TimTini/modular-window-screen/exports/fit-kit.png

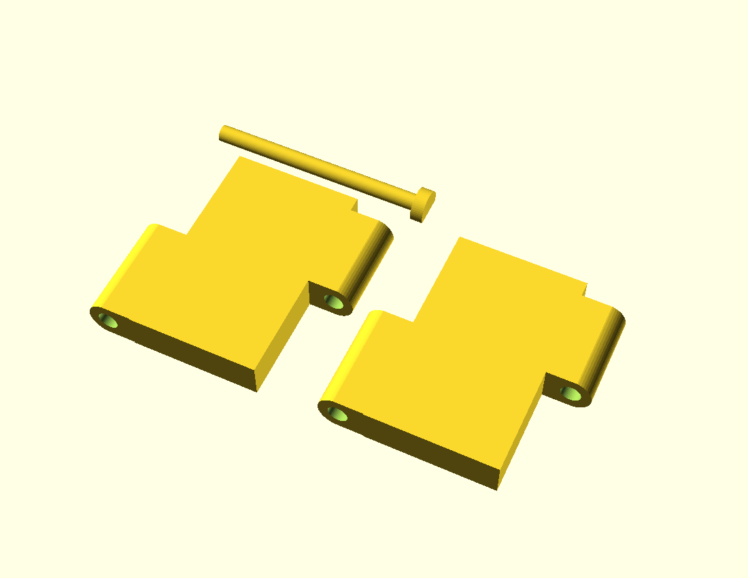
exports/fit-kit.png
