TimTini/modular-window-screen/exports/leaf-section.png

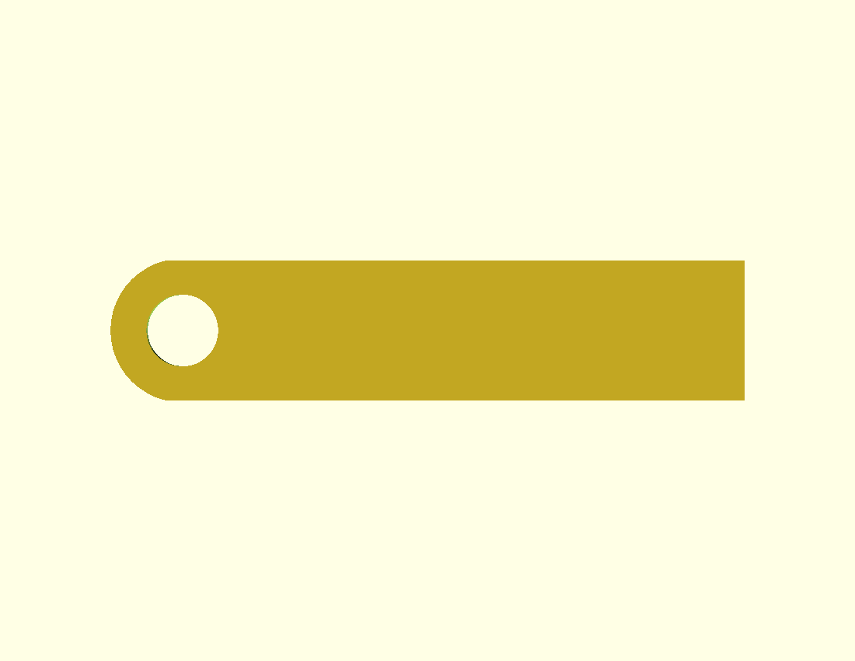
exports/leaf-section.png
