TimTini/modular-window-screen/docs/parts/rod-socket.png

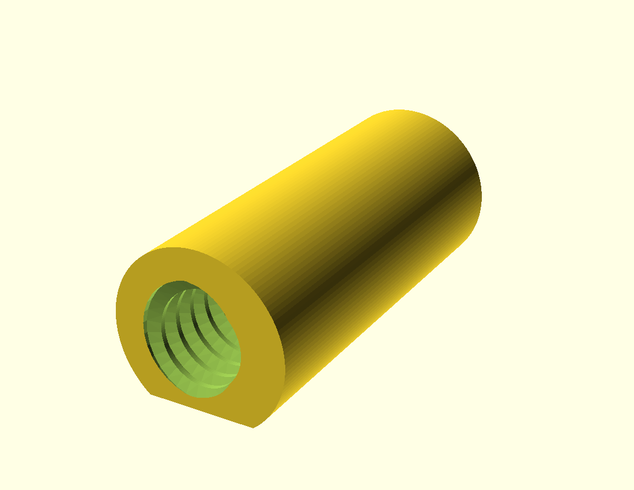
docs/parts/rod-socket.png
