TimTini/modular-window-screen/exports/assembly-tightened.stl

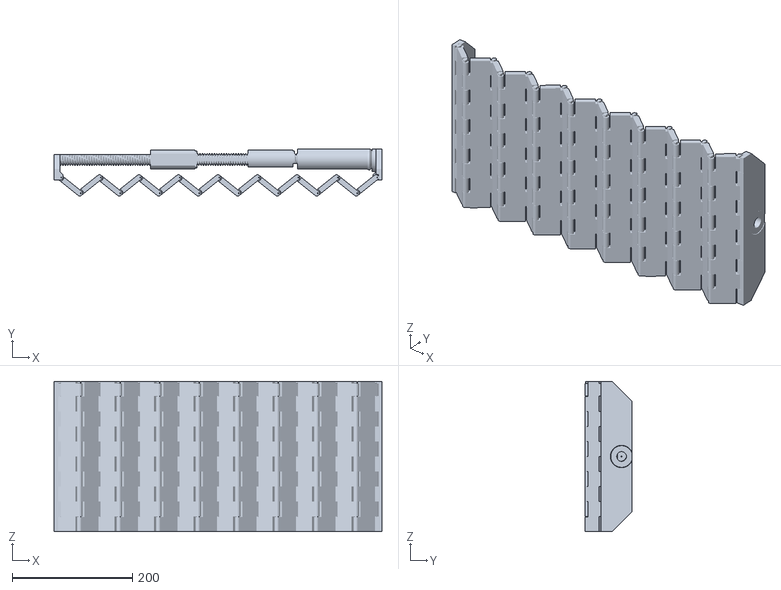
[picture p15: CAD file, 2026-10-26]
exports/assembly-tightened.stl
545.0 x 78.1 x 250.0
