TimTini/modular-window-screen/exports/accordion.3mf

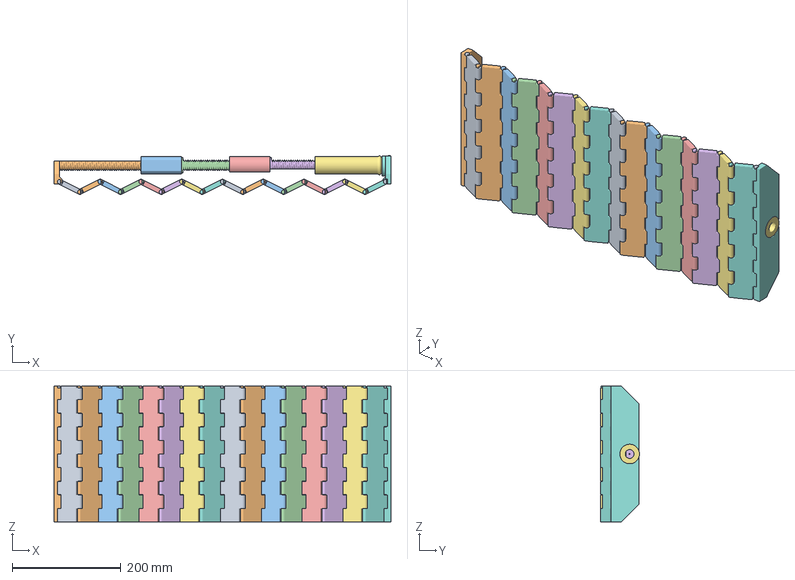
[picture p16: CAD file, 2026-10-26]
exports/accordion.3mf
620.0 x 71.5 x 250.0 mm
leaf-00
leaf-01
leaf-02
leaf-03
leaf-04
leaf-05
leaf-06
leaf-07
leaf-08
leaf-09
leaf-10
leaf-11
leaf-12
leaf-13
leaf-14
leaf-15
pin-00
pin-01
pin-02
pin-03
pin-04
pin-05
pin-06
pin-07
pin-08
pin-09
pin-10
pin-11
pin-12
pin-13
pin-14
pin-15
pin-16
left-support
extension-00-socket
extension-00-shaft
extension-01-socket
extension-01-shaft
female-rotor
right-support
