TimTini/modular-window-screen/exports/parts/rod-extension.stl

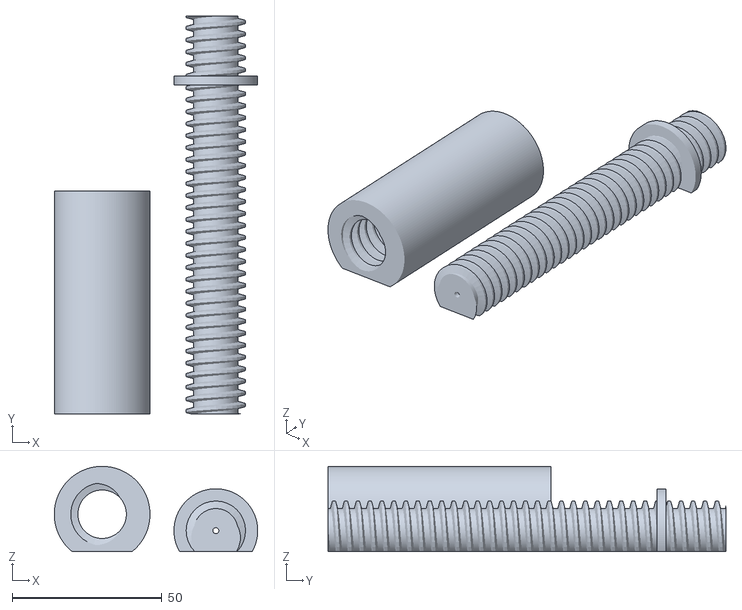
[picture p17: CAD file, 2026-10-26]
exports/parts/rod-extension.stl
68.0 x 133.0 x 28.5
