TimTini/modular-window-screen/exports/fit-kit.stl

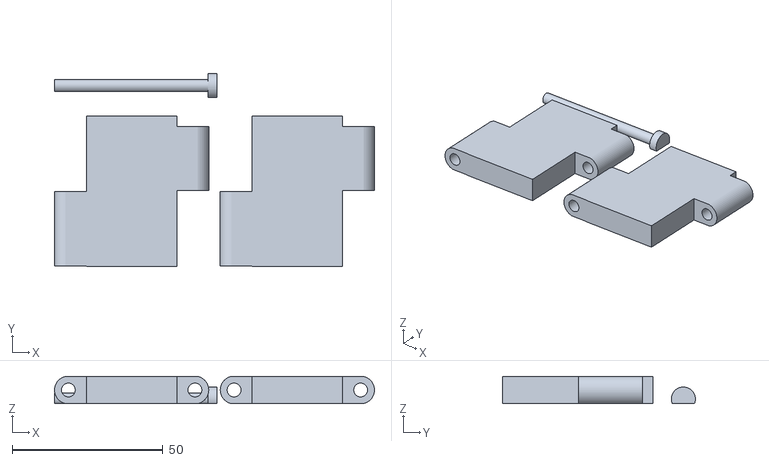
[picture p18: CAD file, 2026-10-26]
exports/fit-kit.stl
106.2 x 64.0 x 9.00
