TimTini/modular-window-screen/exports/parts/hinge-pin.stl

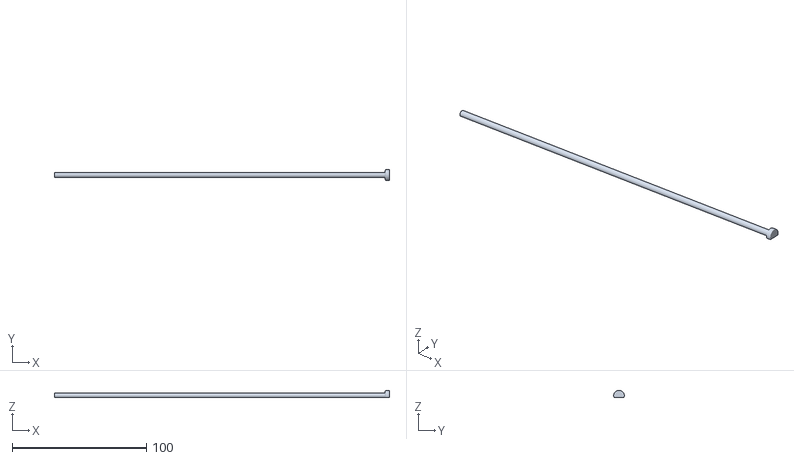
[picture p19: CAD file, 2026-10-26]
exports/parts/hinge-pin.stl
250.0 x 8.00 x 5.50
