TimTini/modular-window-screen/exports/parts/test-female.stl

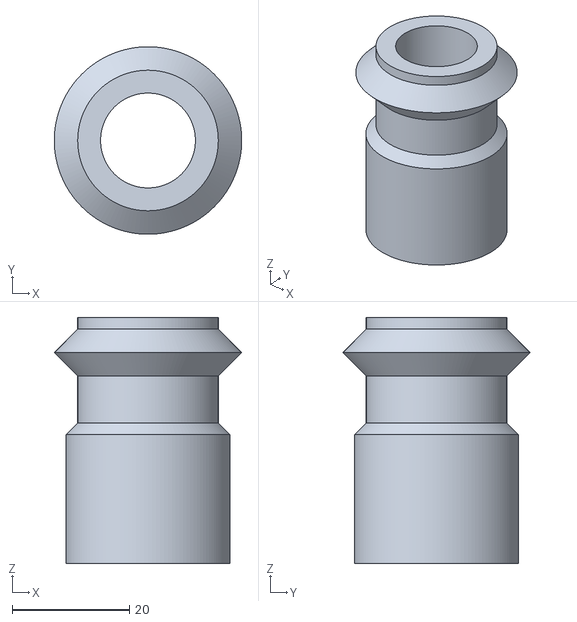
[picture p20: CAD file, 2026-10-26]
exports/parts/test-female.stl
32.0 x 32.0 x 42.0
