TimTini/modular-window-screen/exports/parts/left-support.stl

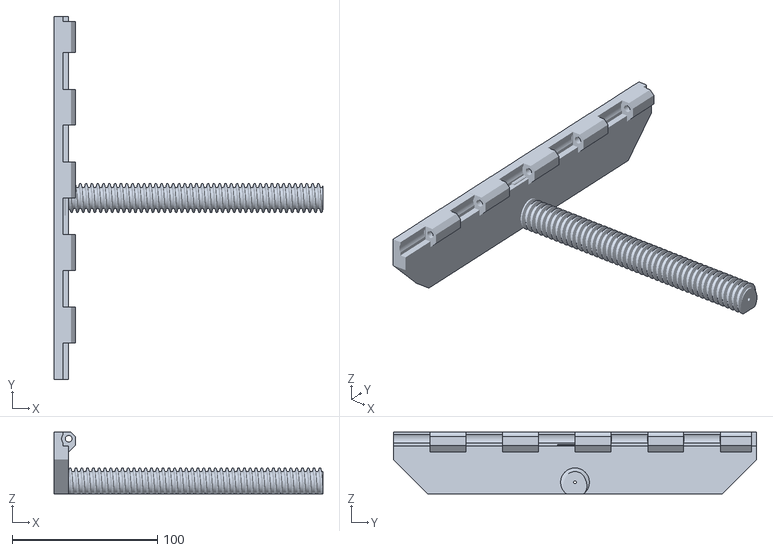
[picture p21: CAD file, 2026-10-26]
exports/parts/left-support.stl
185.0 x 250.0 x 42.6
