TimTini/modular-window-screen/exports/leaf.3mf

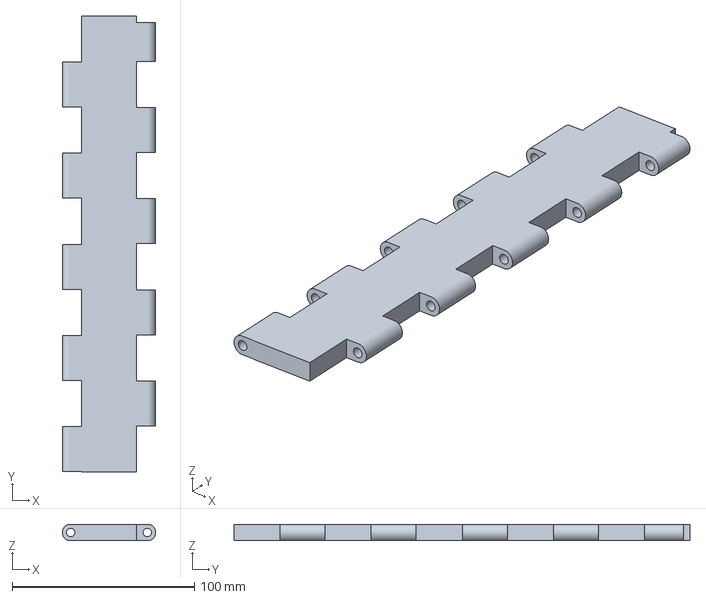
[picture p22: CAD file, 2026-10-26]
exports/leaf.3mf
51.2 x 250.0 x 9.00 mm
