TimTini/modular-window-screen/exports/parts/rod-socket.stl

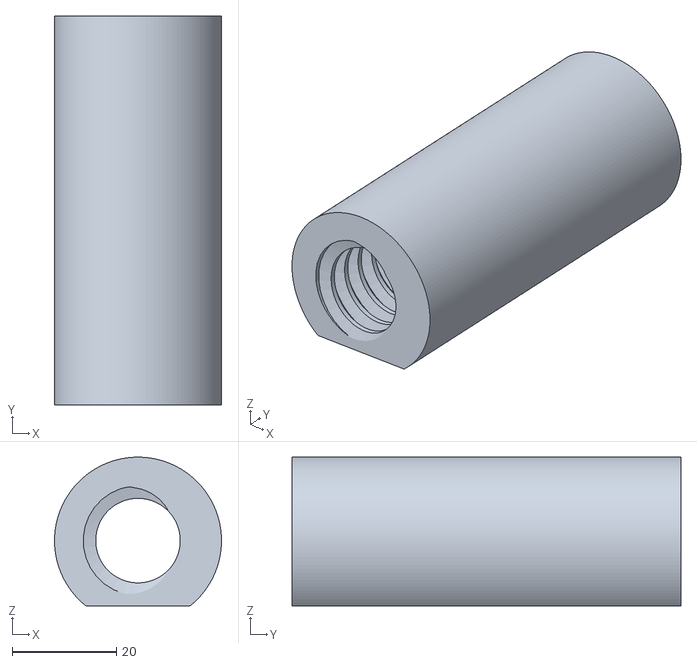
[picture p23: CAD file, 2026-10-26]
exports/parts/rod-socket.stl
32.0 x 74.5 x 28.5
