TimTini/modular-window-screen/exports/parts/right-support.stl

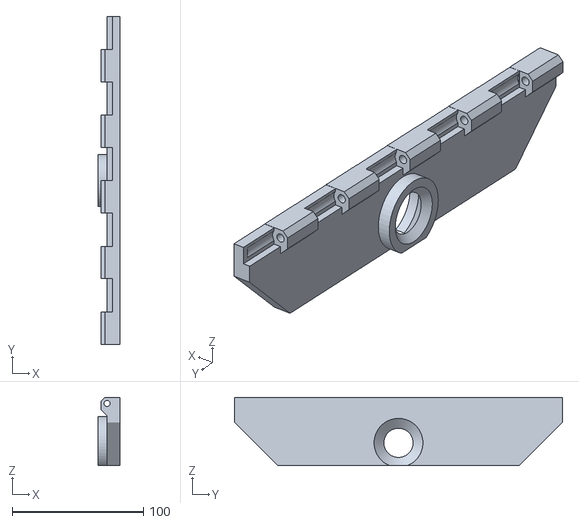
[picture p24: CAD file, 2026-10-26]
exports/parts/right-support.stl
17.0 x 250.0 x 51.9
