TimTini/modular-window-screen/exports/parts/pip-coupon.stl

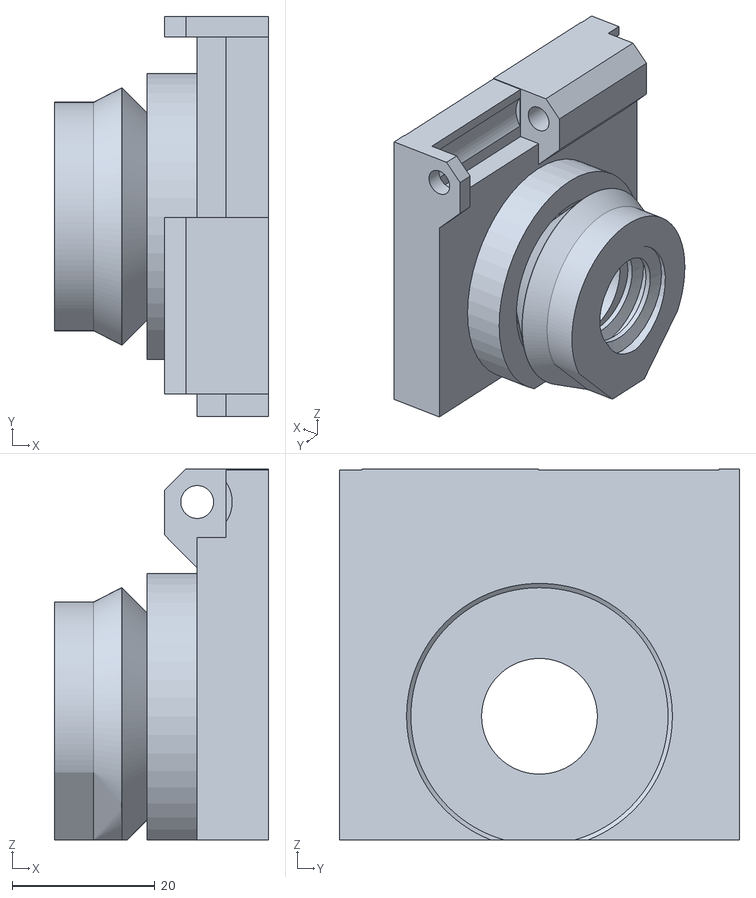
[picture p25: CAD file, 2026-10-26]
exports/parts/pip-coupon.stl
30.0 x 56.0 x 51.9
