TimTini/modular-window-screen/exports/parts/rod-shaft.stl

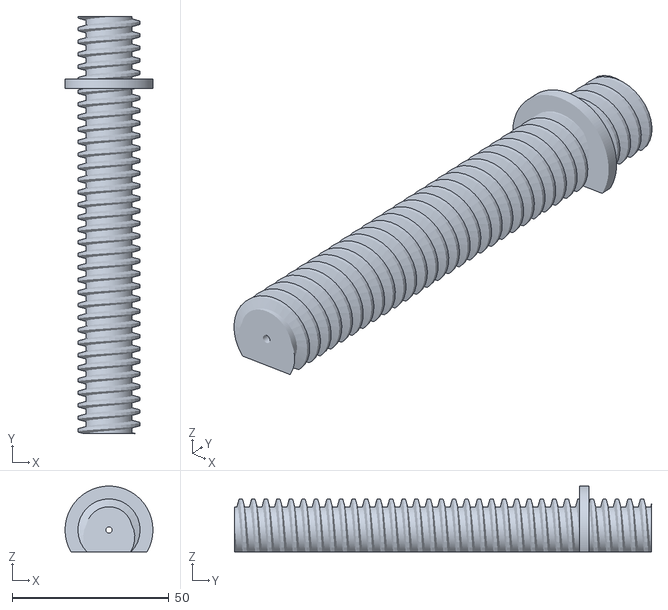
[picture p26: CAD file, 2026-10-26]
exports/parts/rod-shaft.stl
28.0 x 133.0 x 21.0
