TimTini/modular-window-screen/exports/parts/right-pip.3mf

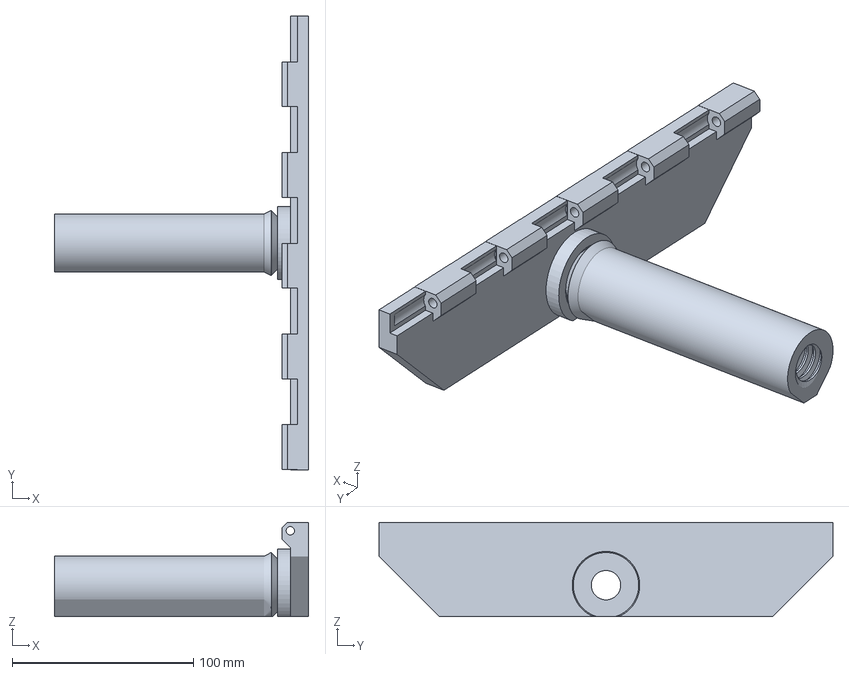
[picture p27: CAD file, 2026-10-26]
exports/parts/right-pip.3mf
140.0 x 250.0 x 51.9 mm
