TimTini/modular-window-screen/exports/parts/test-male.stl

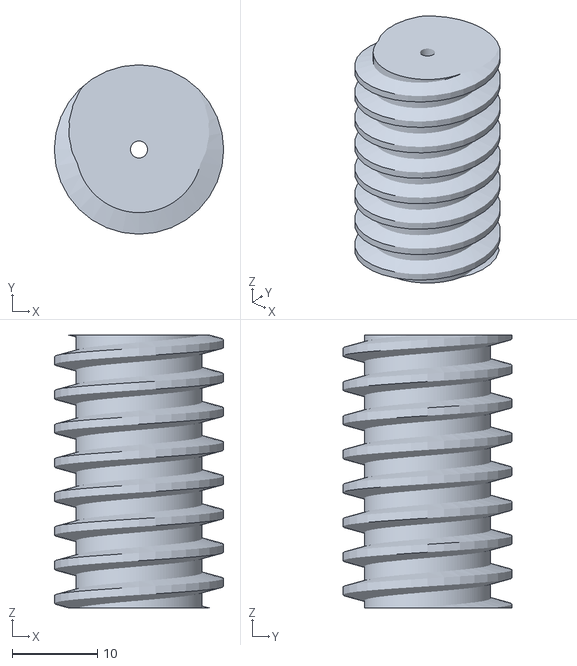
[picture p28: CAD file, 2026-10-26]
exports/parts/test-male.stl
19.8 x 19.8 x 32.0
