TimTini/modular-window-screen/(list of files, cad)

Other CAD files:
fusion/AccordionV42/reference/accordion.stl
fusion/AccordionV42/reference/accordion.scad
exports/accordion-separated.stl
exports/accordion.stl
exports/parts/leaf.stl
exports/parts/right-pip.stl
fusion/AccordionV42/exports/AccordionV42-W620.f3d
