TimTini/modular-window-screen/docs/parts/rod-extension-assembled.png

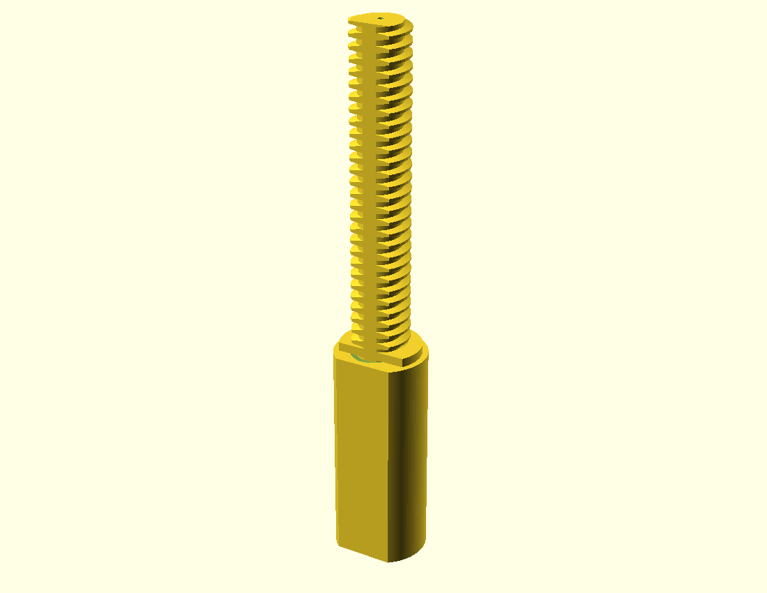
docs/parts/rod-extension-assembled.png
