TimTini/modular-window-screen/exports/assembly-rear.png

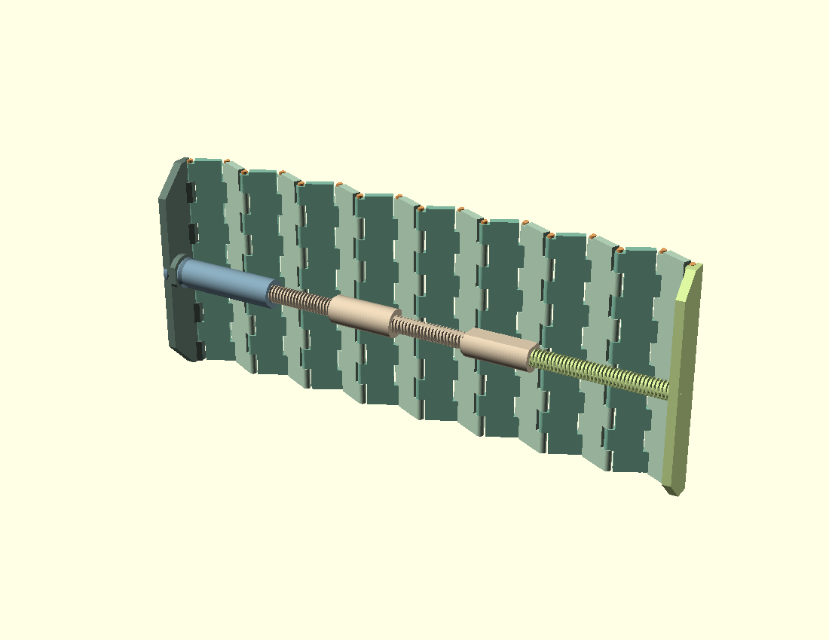
exports/assembly-rear.png
