TimTini/modular-window-screen/verification.ini

# Offline diagnostic profile only. Not a printer-specific production profile.
layer_height = 0.2
first_layer_height = 0.2
nozzle_diameter = 0.4
filament_diameter = 1.75
filament_type = PLA
temperature = 210
first_layer_temperature = 210
bed_temperature = 60
first_layer_bed_temperature = 60
bed_shape = 0x0,250x0,250x250,0x250
max_print_height = 250
perimeters = 3
top_solid_layers = 5
bottom_solid_layers = 5
fill_density = 100%
fill_pattern = rectilinear
support_material = 1
support_material_auto = 1
support_material_threshold = 45
support_material_buildplate_only = 0
support_material_enforce_layers = 0
dont_support_bridges = 0
raft_layers = 0
skirts = 0
brim_width = 0
binary_gcode = 0
gcode_comments = 1
start_gcode =
end_gcode =
