TimTini/modular-window-screen/(commit log)

2026-10-26 Publish portable CAD sources and validated artifacts
    [AccordionV42-W620.f3d, accordion-separated.3mf, accordion-separated.stl, accordion.3mf, accordion.scad, accordion.stl, assembly-tightened.stl, fit-kit.stl]
2026-10-26 Preserve exact CAD source and artifact bytes across clones
    [accordion.scad, threads.scad]
